barlasardic/nano-delay-pedal/manufacturing/DRILL-REPORT.txt

Drill report for delay-pedal.kicad_pcb
Created on 2026-10-10T01:16:54+0300

Copper Layer Stackup:
    =============================================================
    L1 :  F.Cu                      front
    L2 :  B.Cu                      back

Drill file 'delay-pedal-PTH.drl' contains
    plated through holes:
    =============================================================
    T1  0.300mm  0.0118"  (44 holes)
    T2  0.700mm  0.0276"  (44 holes)
    T3  0.750mm  0.0295"  (4 holes)
    T4  0.800mm  0.0315"  (61 holes)
    T5  1.000mm  0.0394"  (51 holes)
    T6  1.100mm  0.0433"  (5 holes)

    Total plated holes count 209

Drill file 'delay-pedal-NPTH.drl' contains
    unplated through holes:
    =============================================================
    T1  2.700mm  0.1063"  (4 holes)

    Total unplated holes count 4
