barlasardic/nano-delay-pedal/docs/mechanical-fit.pdf

# CUSTOM COMPACT PEDAL / FIT PLAN

Revision C - enclosure concept, dimensions in mm

73 x 129 x 59 overall reference; exact panel hardware must be selected.

129

CUSTOM HOUSING ASSUMPTIONS

Wall thickness: 2.5

PCB origin: X 13.30, Y 8.00

Nano USB face: X 70.50

PCB holes in enclosure coordinates:

H1 17.11, 11.81

H2 65.37, 11.81

H3 17.11, 93.09

H4 65.37, 93.09

Solid green: PCB and Nano
Gold outlines: proposed panel parts Dashed gold: jack body reservations Jack bodies overlap the PCB in plan; their height must clear the components. USB opening shown in blue.
Cutout size depends on Nano and plug.

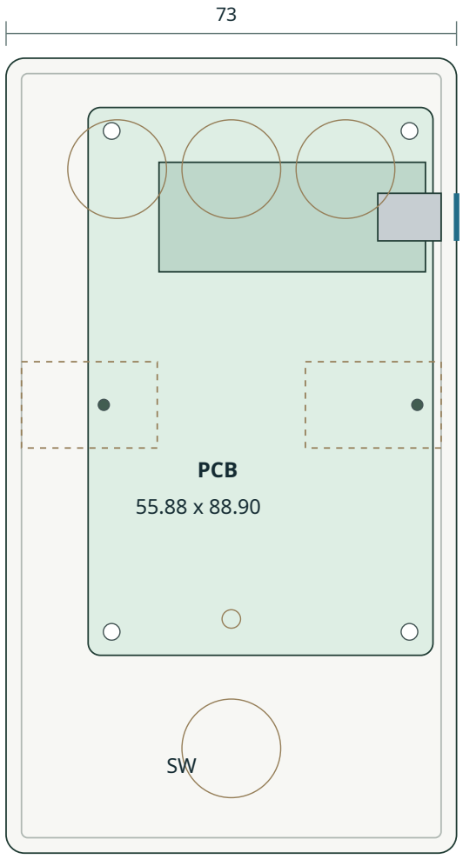
[picture p3: figure]
PCB 55.88 x 88.90

Fit checks before drilling the enclosure

Use the selected jack, pot, switch and Nano drawings to set panel holes.

Start with 5 mm clearance below the PCB and 25 mm above it; confirm actual heights.

The 59 mm figure is an overall pedal reference, including external hardware.

Provide room for knobs, panel thickness, plugs, wires and strain relief.

This concept does not guarantee fit in an existing BOSS enclosure.

Reference: BOSS DS-1 published external dimensions (see design-review.md).

ENCLOSURE CONCEPT - use the next page for the exact PCB mounting pattern.

# PCB MOUNTING TEMPLATE / 1:1

Revision C - component side - print at 100%, with scaling disabled

Check the 50 mm scale bar with a ruler before transferring holes.

55.88

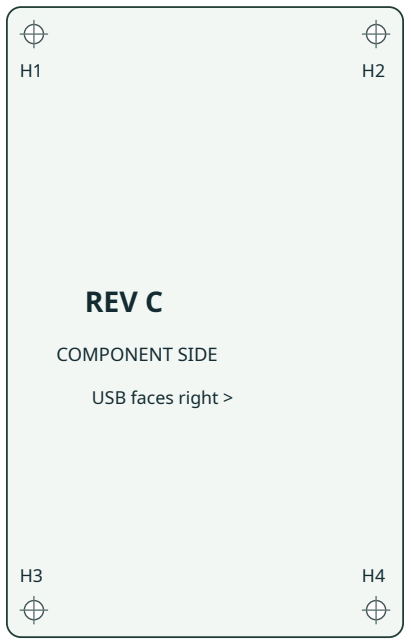
[picture p4: figure]
REV C; COMPONENT SIDE; USB faces right >

88.90

BOARD SPECIFICATION
55.88 x 88.90 x 1.60
Corner radius: 2.00
4 x diameter 2.70 NPTH
For M2.5 insulated standoffs Hole spacing: 48.26 x 81.28

HOLE CENTERS (PCB ORIGIN)
H1 3.81, 3.81
H2 52.07, 3.81
H3 3.81, 85.09
H4 52.07, 85.09

Origin: top-left board envelope X right; Y down.

50 mm calibration

Use this page only for PCB outline and mounting holes.

Do not use it to drill jack, pot, footswitch or USB openings.

Use insulated spacers; verify screw-head and wire clearances.

Keep the top/bottom orientation consistent when transferring the pattern.

Manufacturing board outline is the matching Edge.Cuts Gerber.

Dimensions are authoritative; reject any print whose calibration bar is not 50 mm.
