barlasardic/nano-delay-pedal/manufacturing/PROTOTYPE-NOTE.txt

Revision C, 2026-10-10. Unbuilt prototype; no firmware.
Read FABRICATION.txt and BOM.txt before manufacture.
CAD checks pass; circuit operation and enclosure fit require validation.
