barlasardic/nano-delay-pedal/manufacturing/assembly-top.pdf

# NANO DELAY / ASSEMBLY MAP

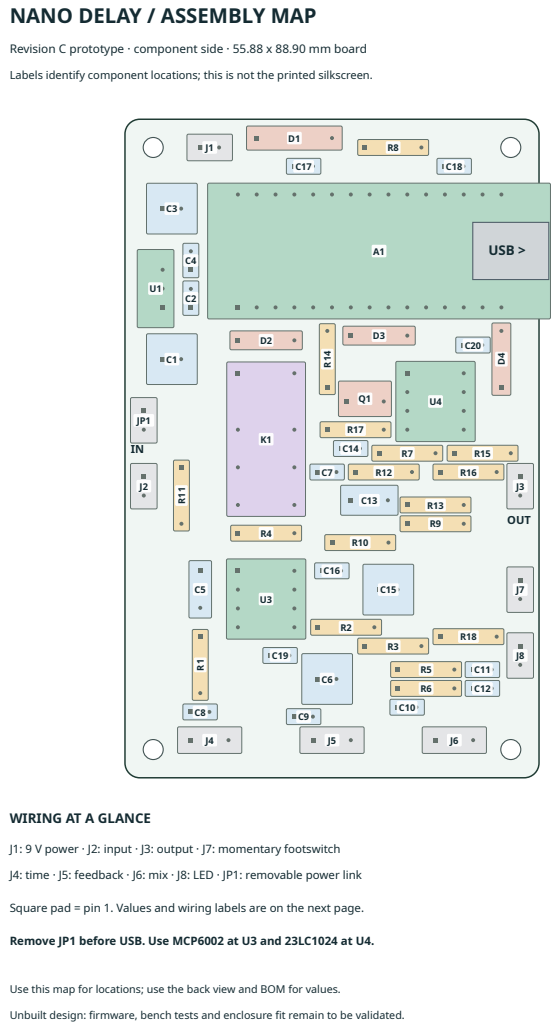
[picture p5: page 1]

Revision C prototype · component side · 55.88 x 88.90 mm board
Labels identify component locations; this is not the printed silkscreen. R¹⁴

J1: 9 V power · J2: input · J3: output · J7: momentary footswitch
J4: time · J5: feedback · J6: mix · J8: LED · JP1: removable power link

Square pad = pin 1. Values and wiring labels are on the next page.

Remove JP1 before USB. Use MCP6002 at U3 and 23LC1024 at U4.

Use this map for locations; use the back view and BOM for values.
Unbuilt design: firmware, bench tests and enclosure fit remain to be validated.

# NANO DELAY / VALUES & WIRING

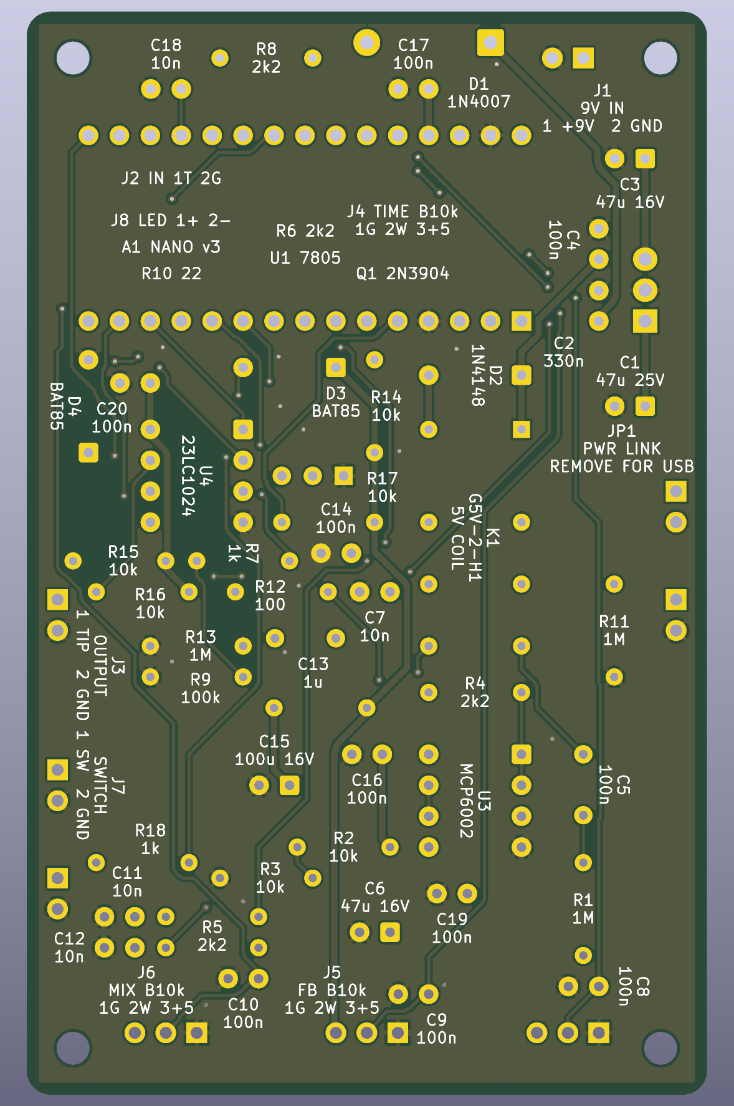
[picture p6: page 2]

Revision C - solder side, as seen from the underside

This view is mirrored relative to the component-side map.

2k2 = 2.2 kOhm; 100n = 100 nF. G = ground, W = wiper, T = tip.
