barlasardic/nano-delay-pedal/docs/assembly-top.pdf

# NANO DELAY / ASSEMBLY MAP

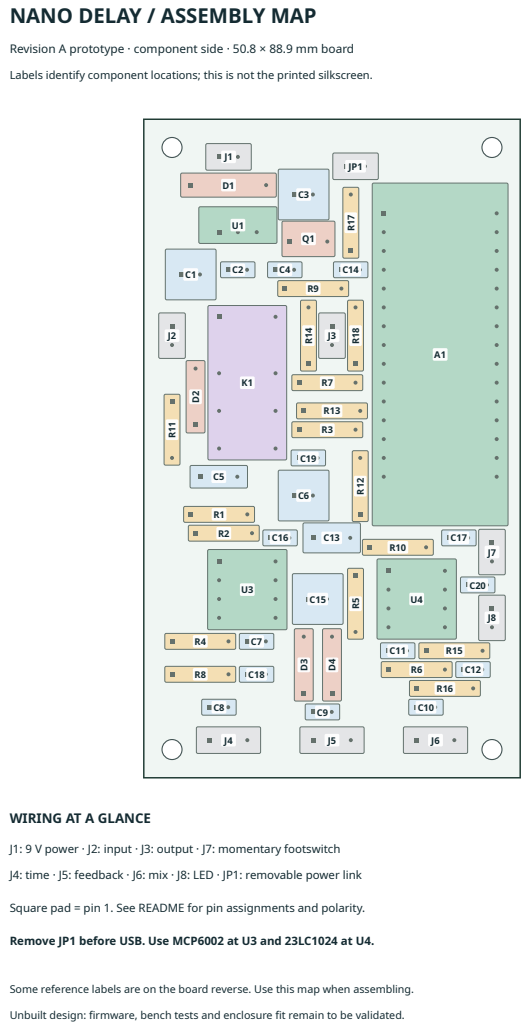
[picture p7: page 1]

Revision A prototype · component side · 50.8 × 88.9 mm board
Labels identify component locations; this is not the printed silkscreen.

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

Square pad = pin 1. See README for pin assignments and polarity.

Remove JP1 before USB. Use MCP6002 at U3 and 23LC1024 at U4.

Some reference labels are on the board reverse. Use this map when assembling.
Unbuilt design: firmware, bench tests and enclosure fit remain to be validated.
