barlasardic/nano-delay-pedal/delay-pedal.pdf

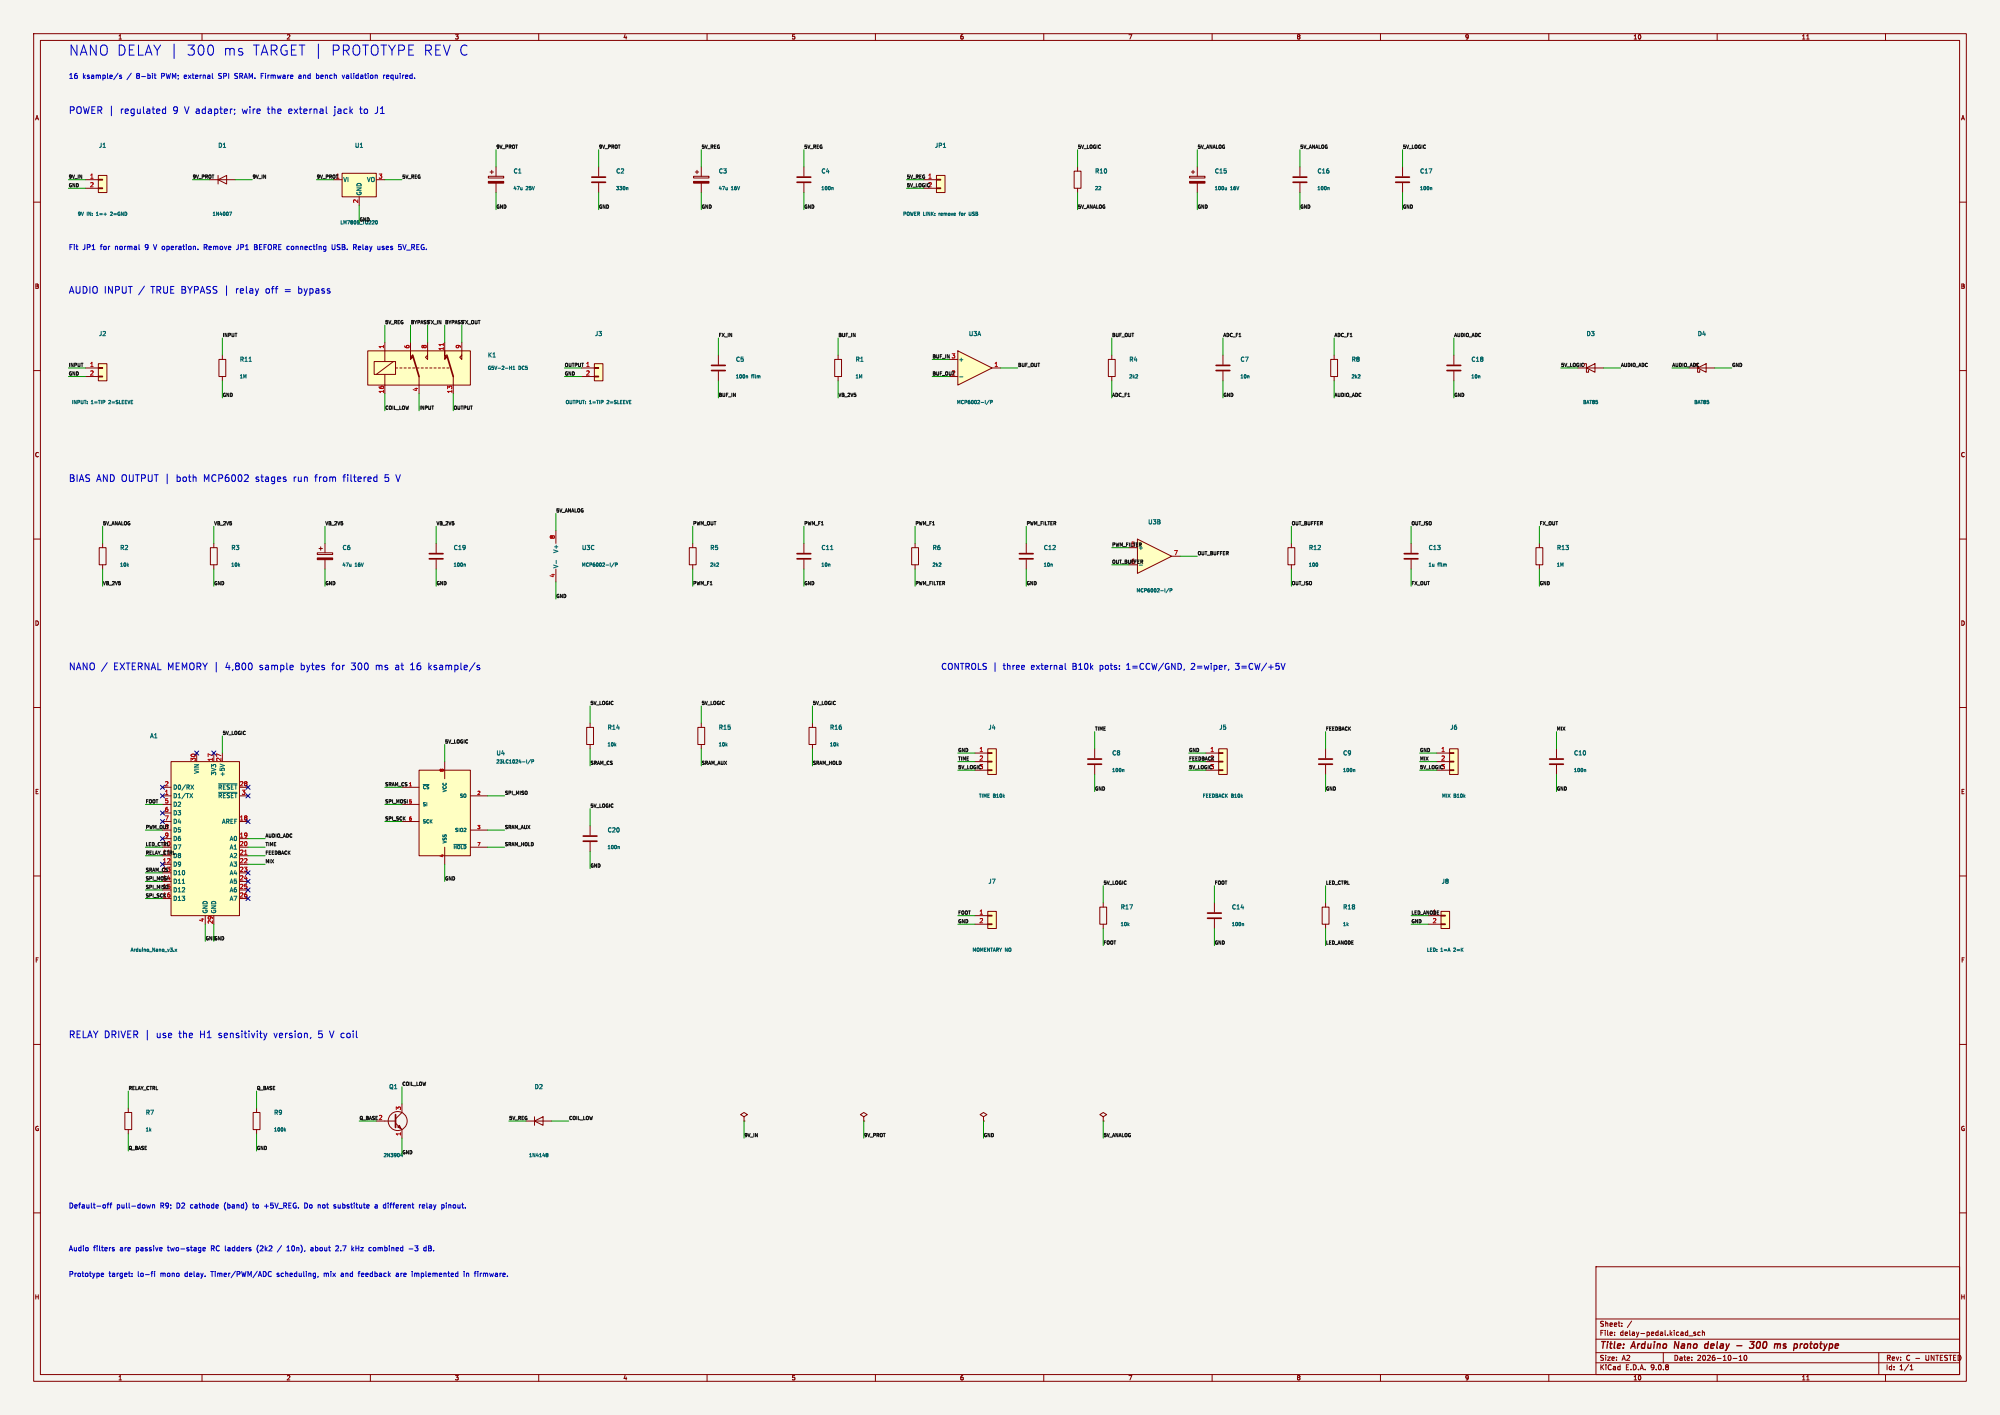
[picture p8: page 1]

NANO DELAY | 300 ms TARGET | PROTOTYPE REV C

POWER LINK: remove for USB V+

AUDIO INPUT / TRUE BYPASS | relay off = bypass

NANO / EXTERNAL MEMORY | 4,800 sample bytes for 300 ms at 16 ksample/s

File: delay-pedal.kicad_sch Sheet: /
