barlasardic/nano-delay-pedal/delay-pedal.kicad_pcb

## KiCad design delay-pedal.kicad_pcb (2026-10-09)

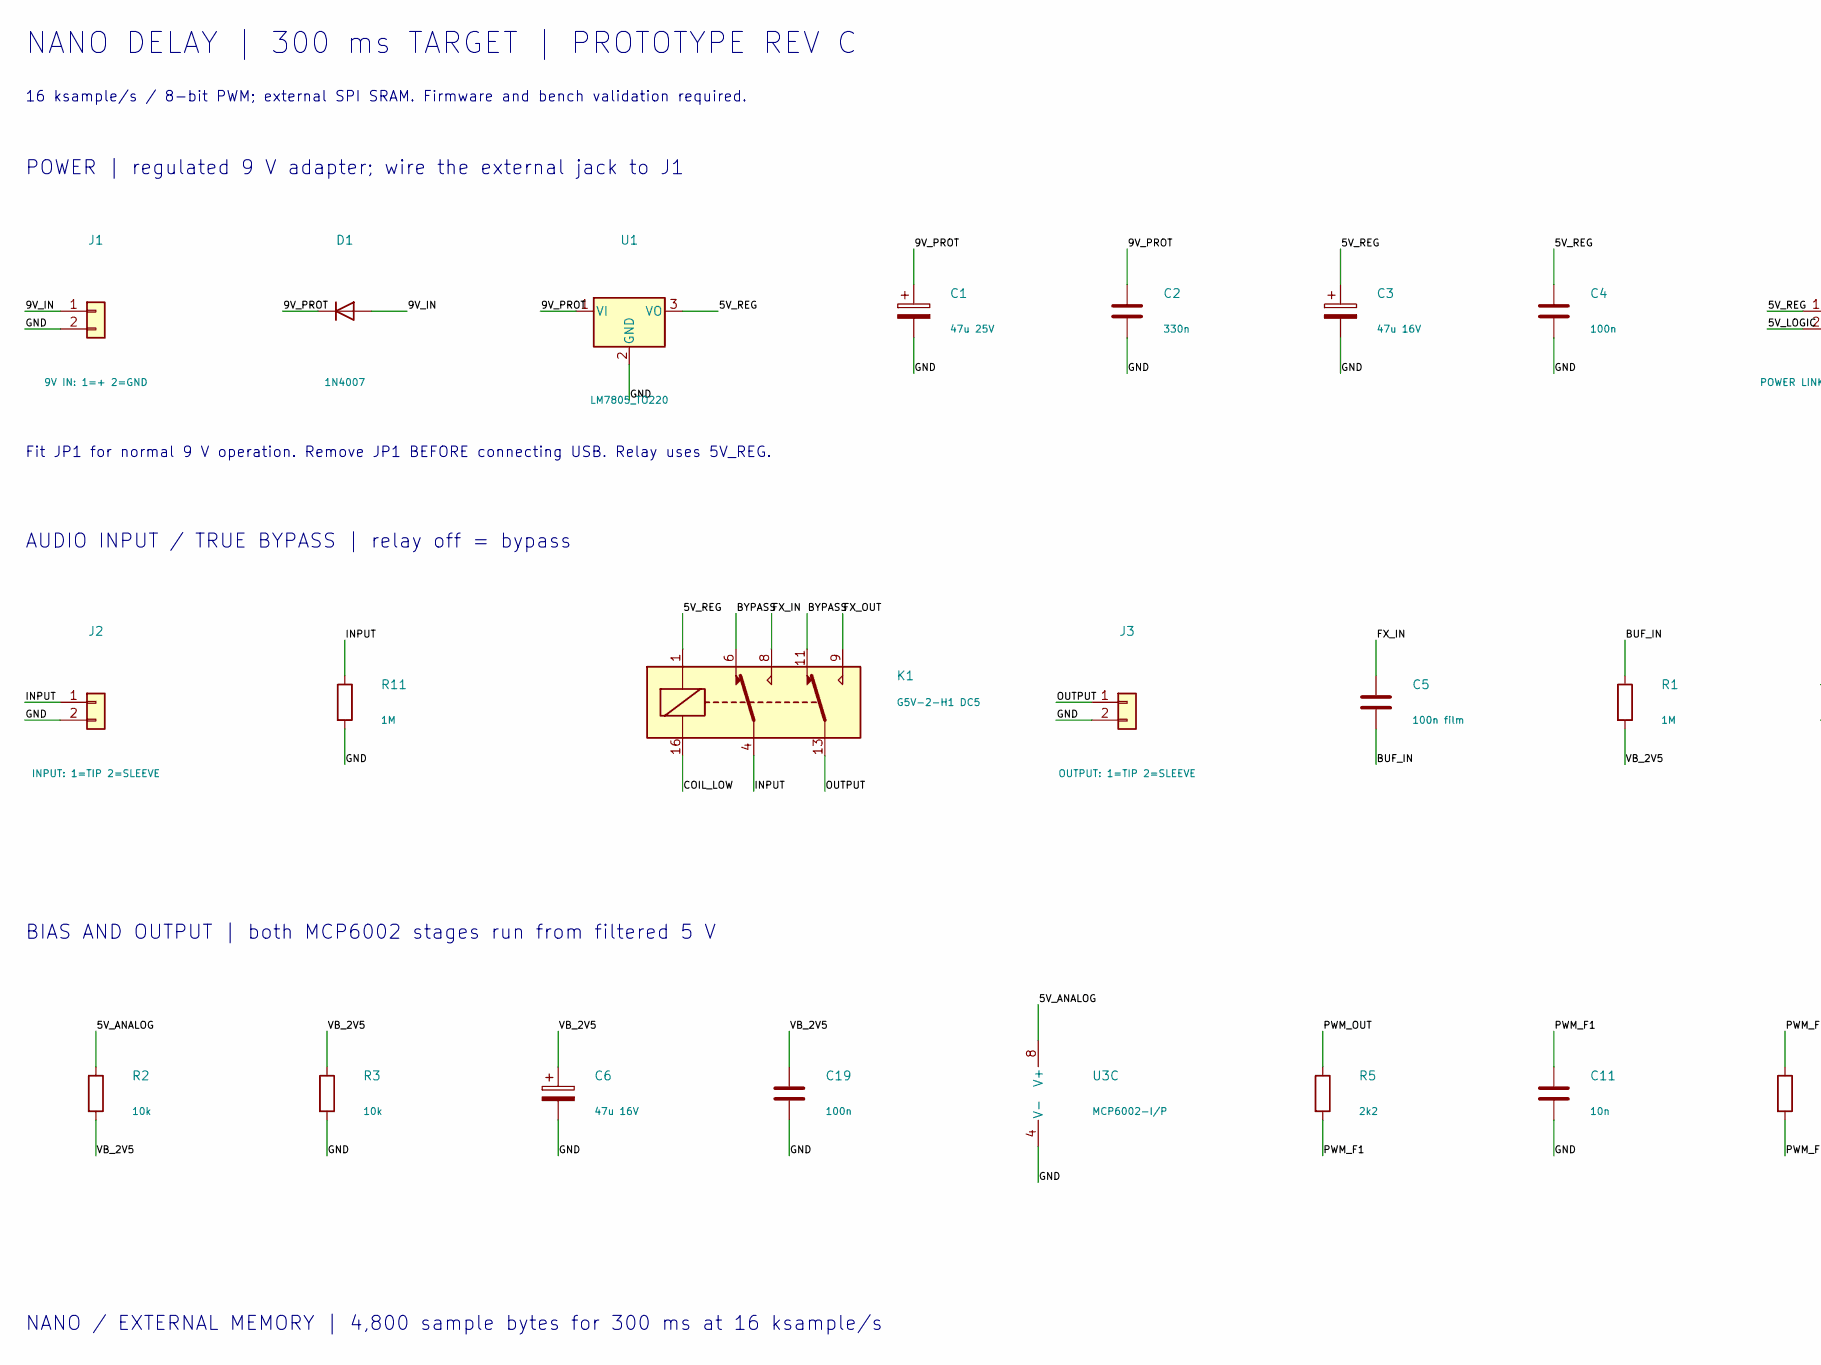
[picture p9: schematic delay-pedal.kicad_sch, Arduino Nano delay - 300 ms prototype, part in row 1, column 1]

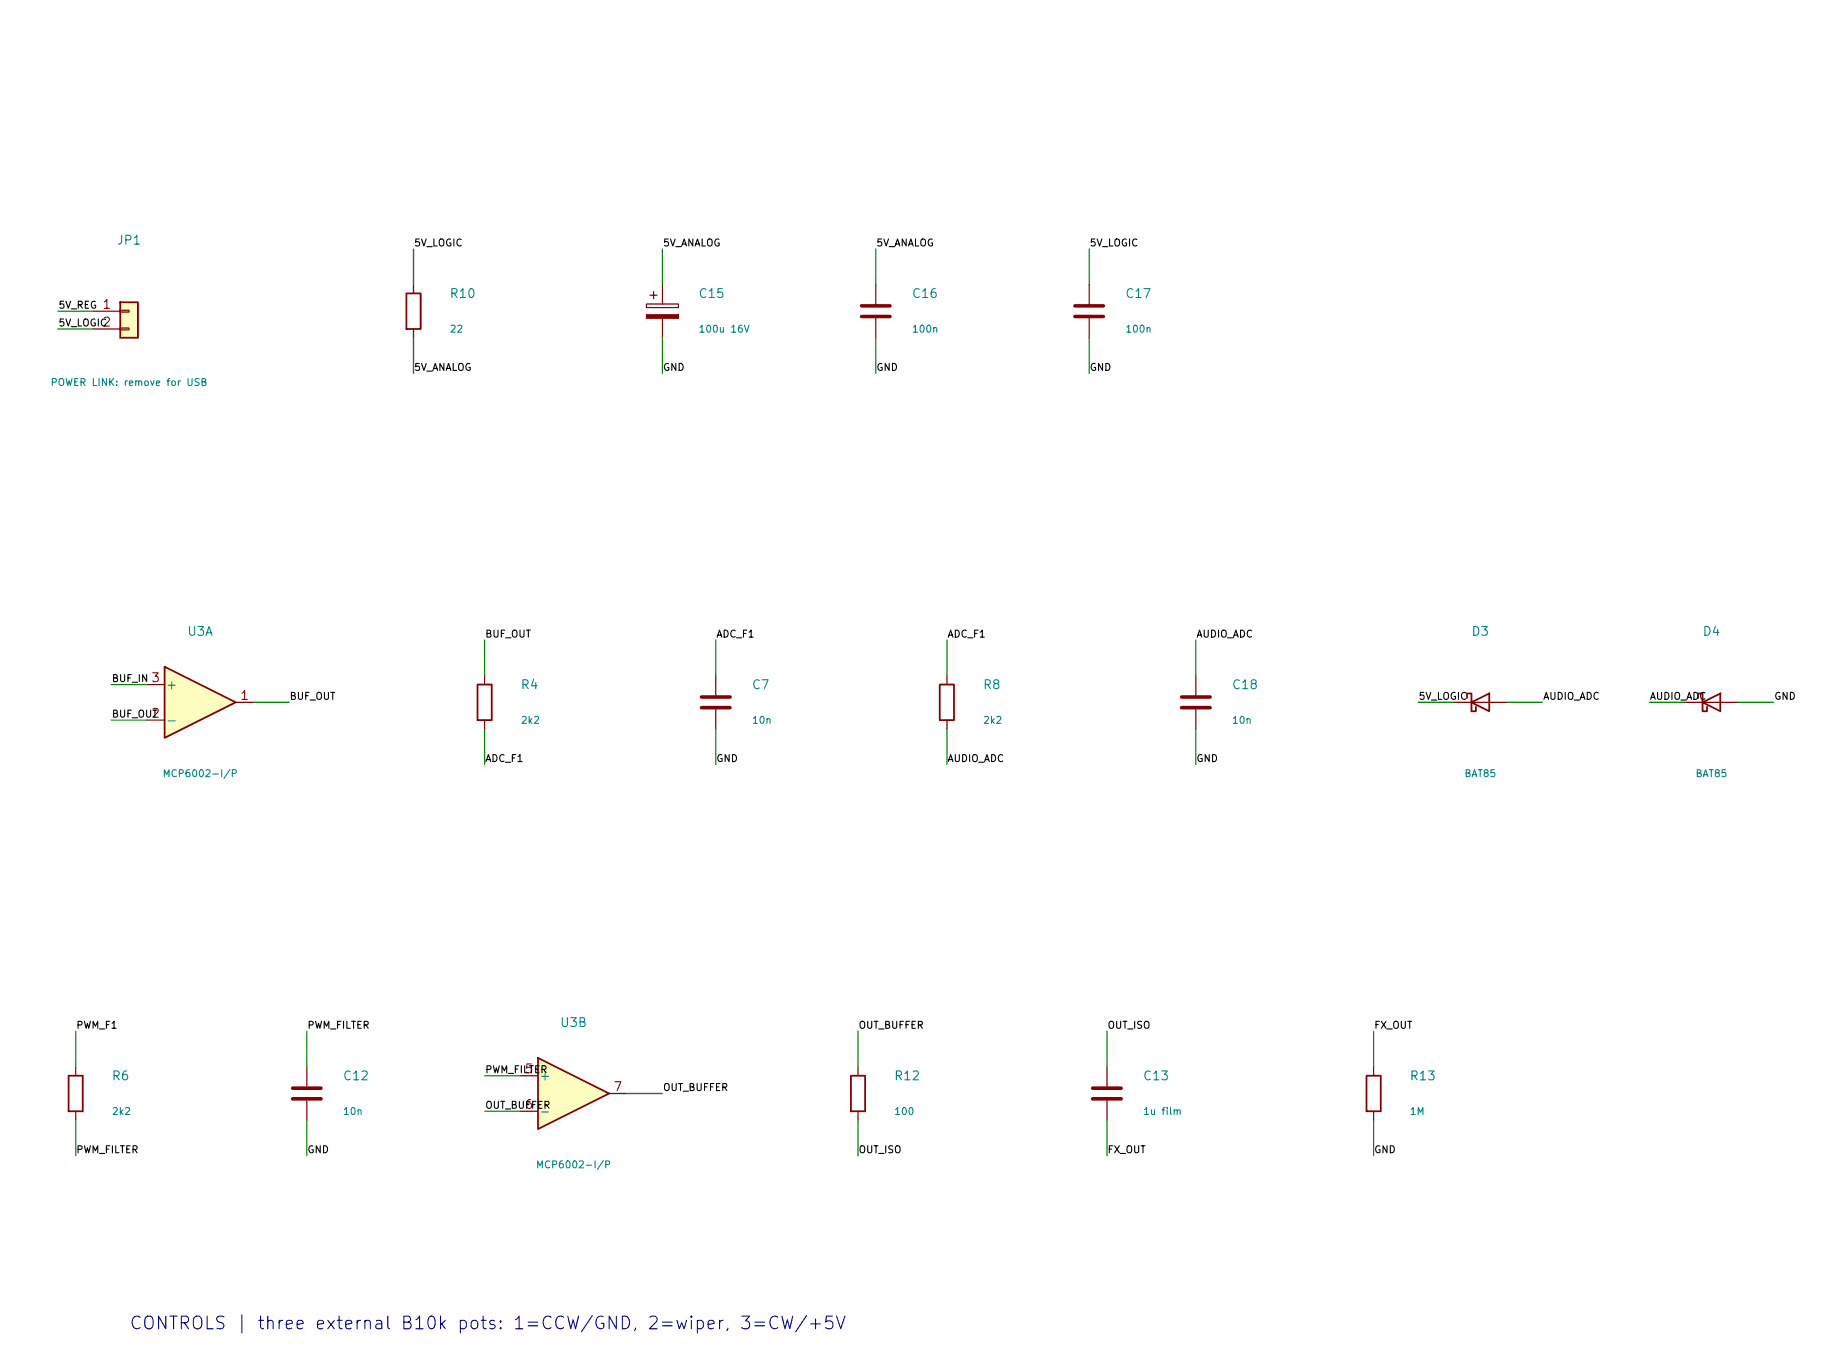
[picture p10: schematic delay-pedal.kicad_sch, Arduino Nano delay - 300 ms prototype, part in row 1, column 2]

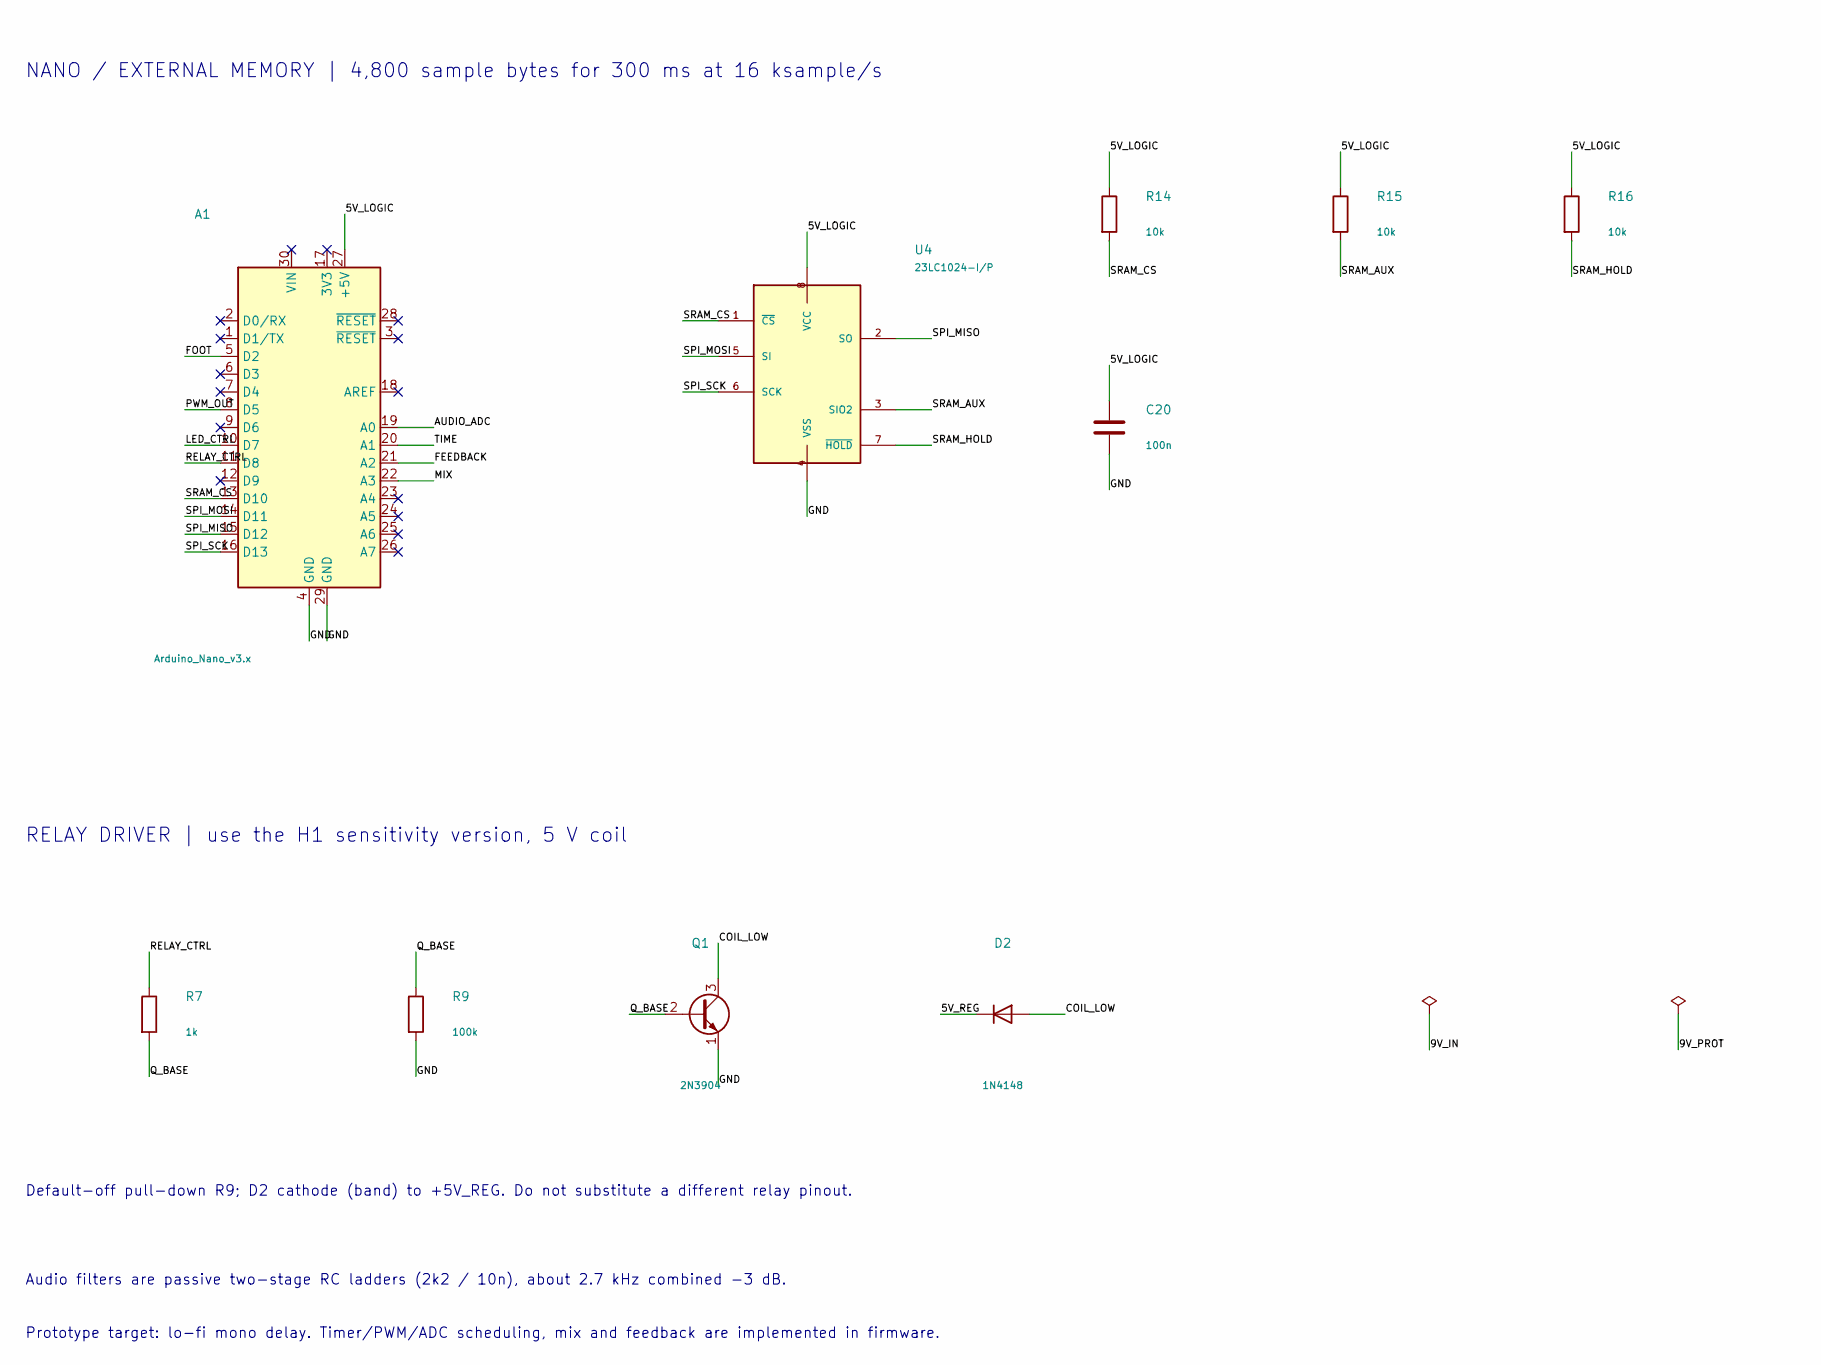
[picture p11: schematic delay-pedal.kicad_sch, Arduino Nano delay - 300 ms prototype, part in row 2, column 1]

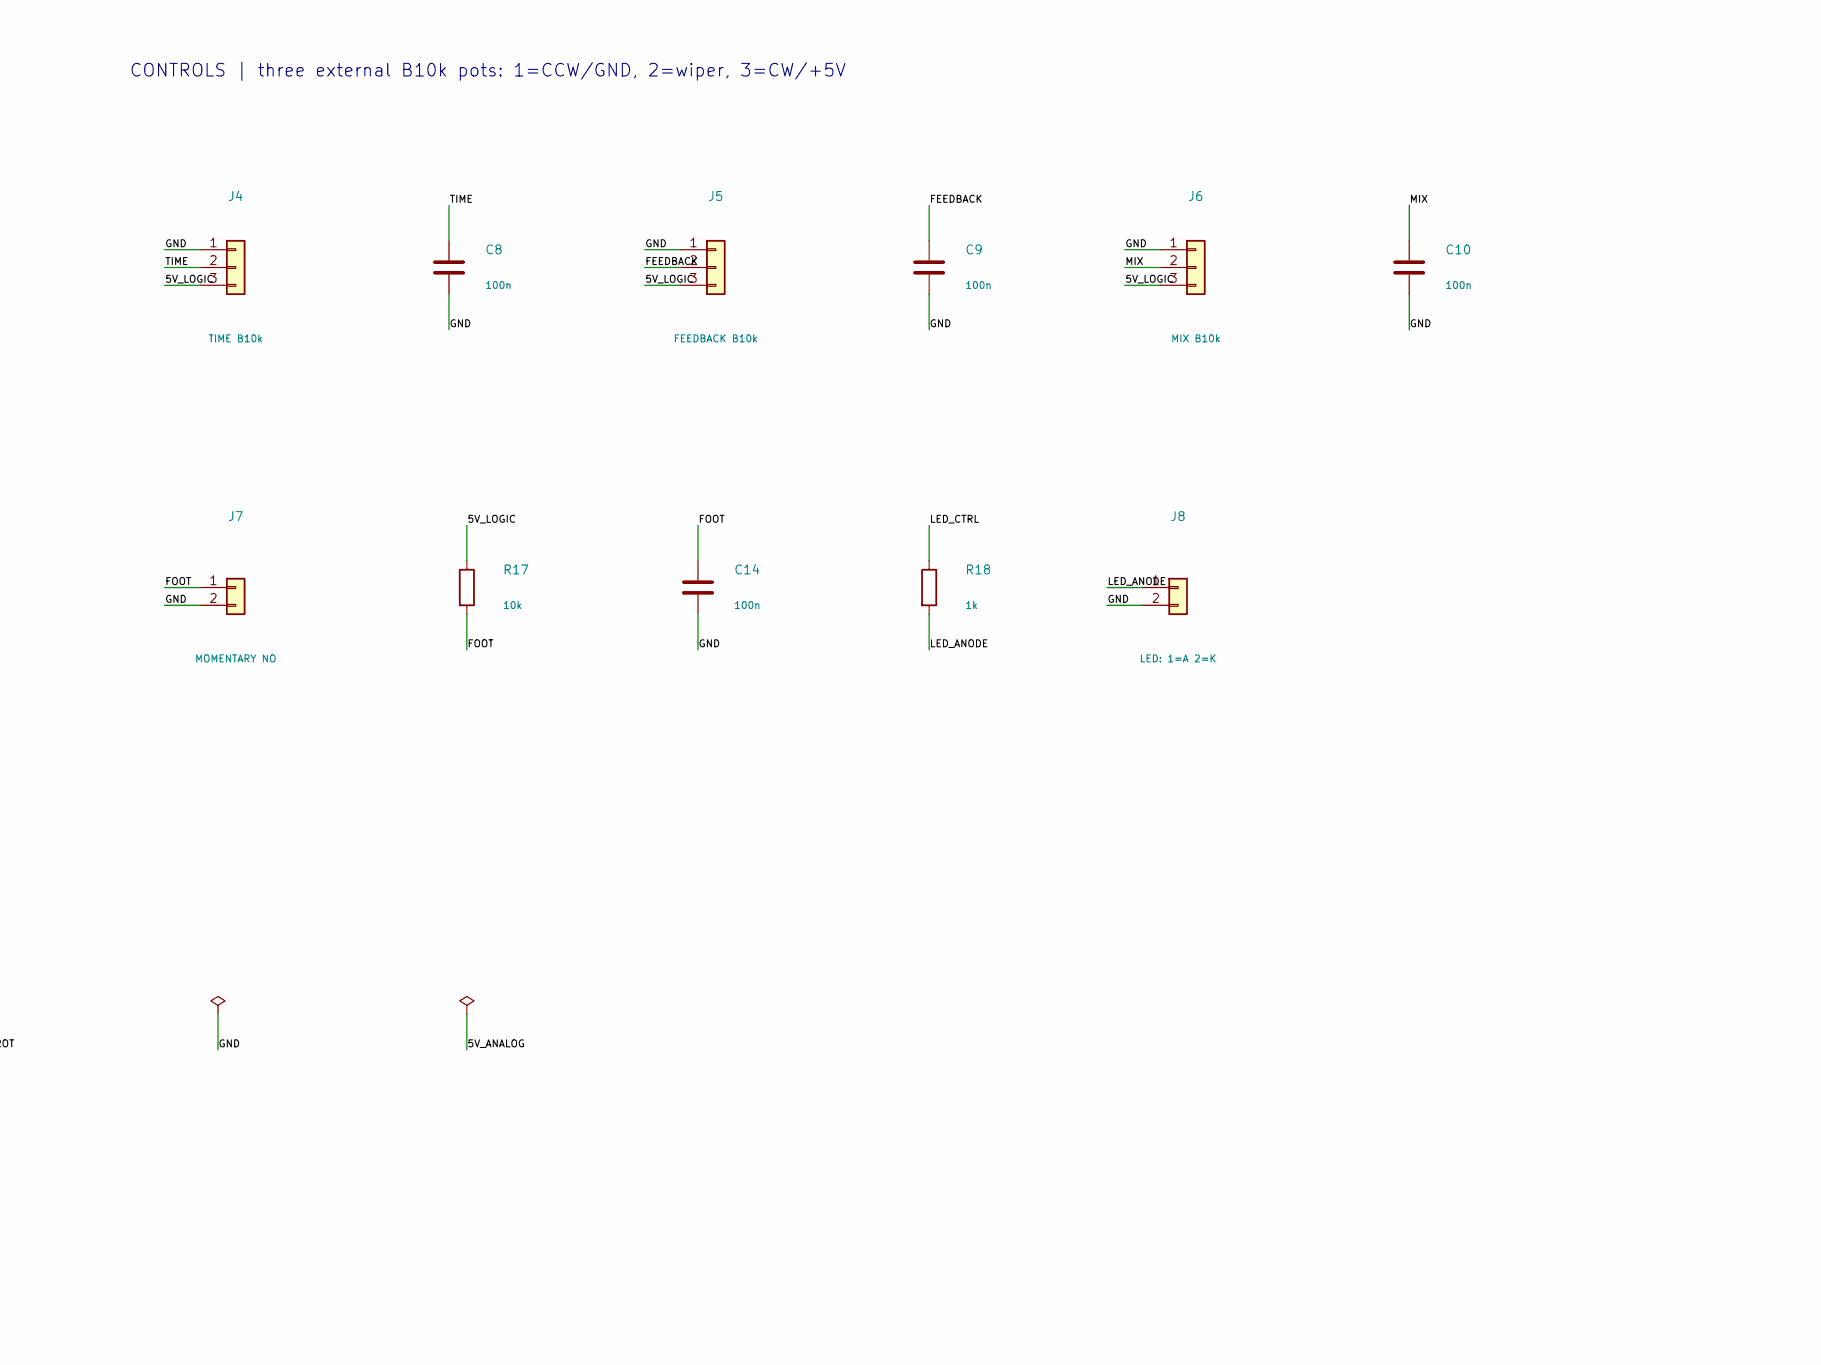
[picture p12: schematic delay-pedal.kicad_sch, Arduino Nano delay - 300 ms prototype, part in row 2, column 2]

Parts:
A1: Arduino_Nano_v3.x; Arduino_Nano_EdgeUSB
C1: 47u 25V; CP_Radial_D6.3mm_P2.50mm
C2: 330n; C_Disc_D3.0mm_W1.6mm_P2.50mm
C3, C6: 47u 16V; CP_Radial_D6.3mm_P2.50mm
C4, C8, C9, C10, C14, C16, C17, C19, C20: 100n; C_Disc_D3.0mm_W1.6mm_P2.50mm
C5: 100n film; C_Rect_L7.2mm_W2.5mm_P5.00mm
C7, C11, C12, C18: 10n; C_Disc_D3.0mm_W1.6mm_P2.50mm
C13: 1u film; C_Rect_L7.2mm_W3.5mm_P5.00mm
C15: 100u 16V; CP_Radial_D6.3mm_P2.50mm
D1: 1N4007; D_DO-41_SOD81_P10.16mm_Horizontal
D2: 1N4148; D_DO-35_SOD27_P7.62mm_Horizontal
D3, D4: BAT85; D_DO-35_SOD27_P7.62mm_Horizontal
J1: 9V IN: 1=+ 2=GND; PinHeader_1x02_P2.54mm_Vertical
J2: INPUT: 1=TIP 2=SLEEVE; PinHeader_1x02_P2.54mm_Vertical
J3: OUTPUT: 1=TIP 2=SLEEVE; PinHeader_1x02_P2.54mm_Vertical
J4: TIME B10k; PinHeader_1x03_P2.54mm_Vertical
J5: FEEDBACK B10k; PinHeader_1x03_P2.54mm_Vertical
J6: MIX B10k; PinHeader_1x03_P2.54mm_Vertical
J7: MOMENTARY NO; PinHeader_1x02_P2.54mm_Vertical
J8: LED: 1=A 2=K; PinHeader_1x02_P2.54mm_Vertical
JP1: POWER LINK: remove for USB; PinHeader_1x02_P2.54mm_Vertical
K1: G5V-2-H1 DC5; Relay_DPDT_Omron_G5V-2
Q1: 2N3904; TO-92_Inline_Wide
R1, R11, R13: 1M; R_Axial_DIN0204_L3.6mm_D1.6mm_P7.62mm_Horizontal
R2, R3, R14, R15, R16, R17: 10k; R_Axial_DIN0204_L3.6mm_D1.6mm_P7.62mm_Horizontal
R4, R5, R6, R8: 2k2; R_Axial_DIN0204_L3.6mm_D1.6mm_P7.62mm_Horizontal
R7, R18: 1k; R_Axial_DIN0204_L3.6mm_D1.6mm_P7.62mm_Horizontal
R9: 100k; R_Axial_DIN0204_L3.6mm_D1.6mm_P7.62mm_Horizontal
R10: 22; R_Axial_DIN0204_L3.6mm_D1.6mm_P7.62mm_Horizontal
R12: 100; R_Axial_DIN0204_L3.6mm_D1.6mm_P7.62mm_Horizontal
U1: LM7805_TO220; TO-220-3_Vertical
U3: MCP6002-I/P; DIP-8_W7.62mm_Socket
U4: 23LC1024-I/P; DIP-8_W7.62mm_Socket

Connections:
/5V_ANALOG: C15.1, C16.1, R2.1, R10.2, U3.8 (V+)
/5V_LOGIC: A1.27 (+5V), C17.1, C20.1, D3.1 (K), J4.3, J5.3, J6.3, JP1.2, R10.1, R14.1, R15.1, R16.1, R17.1, U4.8 (VCC)
/5V_REG: C3.1, C4.1, D2.1 (K), JP1.1, K1.1, U1.3 (VO)
/9V_IN: D1.2 (A), J1.1
/9V_PROT: C1.1, C2.1, D1.1 (K), U1.1 (VI)
/ADC_F1: C7.1, R4.2, R8.1
/AUDIO_ADC: A1.19 (A0), C18.1, D3.2 (A), D4.1 (K), R8.2
/BUF_IN: C5.2, R1.1, U3.3 (+)
/BUF_OUT: R4.1, U3.1, U3.2 (-)
/BYPASS: K1.6, K1.11
/COIL_LOW: D2.2 (A), K1.16, Q1.3 (C)
/FEEDBACK: A1.21 (A2), C9.1, J5.2
/FOOT: A1.5 (D2), C14.1, J7.1, R17.2
/FX_IN: C5.1, K1.8
/FX_OUT: C13.2, K1.9, R13.1
/GND: A1.4 (GND), A1.29 (GND), C1.2, C2.2, C3.2, C4.2, C6.2, C7.2, C8.2, C9.2, C10.2, C11.2, C12.2, C14.2, C15.2, C16.2, C17.2, C18.2, C19.2, C20.2, D4.2 (A), J1.2, J2.2, J3.2, J4.1, J5.1, J6.1, J7.2, J8.2, Q1.1 (E), R3.2, R9.2, R11.2, R13.2, U1.2 (GND), U3.4 (V-), U4.4 (VSS)
/INPUT: J2.1, K1.4, R11.1
/LED_ANODE: J8.1, R18.2
/LED_CTRL: A1.10 (D7), R18.1
/MIX: A1.22 (A3), C10.1, J6.2
/OUTPUT: J3.1, K1.13
/OUT_BUFFER: R12.1, U3.6 (-), U3.7
/OUT_ISO: C13.1, R12.2
/PWM_F1: C11.1, R5.2, R6.1
/PWM_FILTER: C12.1, R6.2, U3.5 (+)
/PWM_OUT: A1.8 (D5), R5.1
/Q_BASE: Q1.2 (B), R7.2, R9.1
/RELAY_CTRL: A1.11 (D8), R7.1
/SPI_MISO: A1.15 (D12), U4.2 (SO)
/SPI_MOSI: A1.14 (D11), U4.5 (SI)
/SPI_SCK: A1.16 (D13), U4.6 (SCK)
/SRAM_AUX: R15.2, U4.3 (SIO2)
/SRAM_CS: A1.13 (D10), R14.2, U4.1 (~CS)
/SRAM_HOLD: R16.2, U4.7 (~HOLD)
/TIME: A1.20 (A1), C8.1, J4.2
/VB_2V5: C6.1, C19.1, R1.2, R2.2, R3.1

Notes on the sheet:
NANO DELAY | 300 ms TARGET | PROTOTYPE REV C
16 ksample/s / 8-bit PWM; external SPI SRAM. Firmware and bench validation required.
POWER | regulated 9 V adapter; wire the external jack to J1
Fit JP1 for normal 9 V operation. Remove JP1 BEFORE connecting USB. Relay uses 5V_REG.
AUDIO INPUT / TRUE BYPASS | relay off = bypass
BIAS AND OUTPUT | both MCP6002 stages run from filtered 5 V
NANO / EXTERNAL MEMORY | 4,800 sample bytes for 300 ms at 16 ksample/s
CONTROLS | three external B10k pots: 1=CCW/GND, 2=wiper, 3=CW/+5V
RELAY DRIVER | use the H1 sensitivity version, 5 V coil
Default-off pull-down R9; D2 cathode (band) to +5V_REG. Do not substitute a different relay pinout.
Audio filters are passive two-stage RC ladders (2k2 / 10n), about 2.7 kHz combined -3 dB.
Prototype target: lo-fi mono delay. Timer/PWM/ADC scheduling, mix and feedback are implemented in firmware.

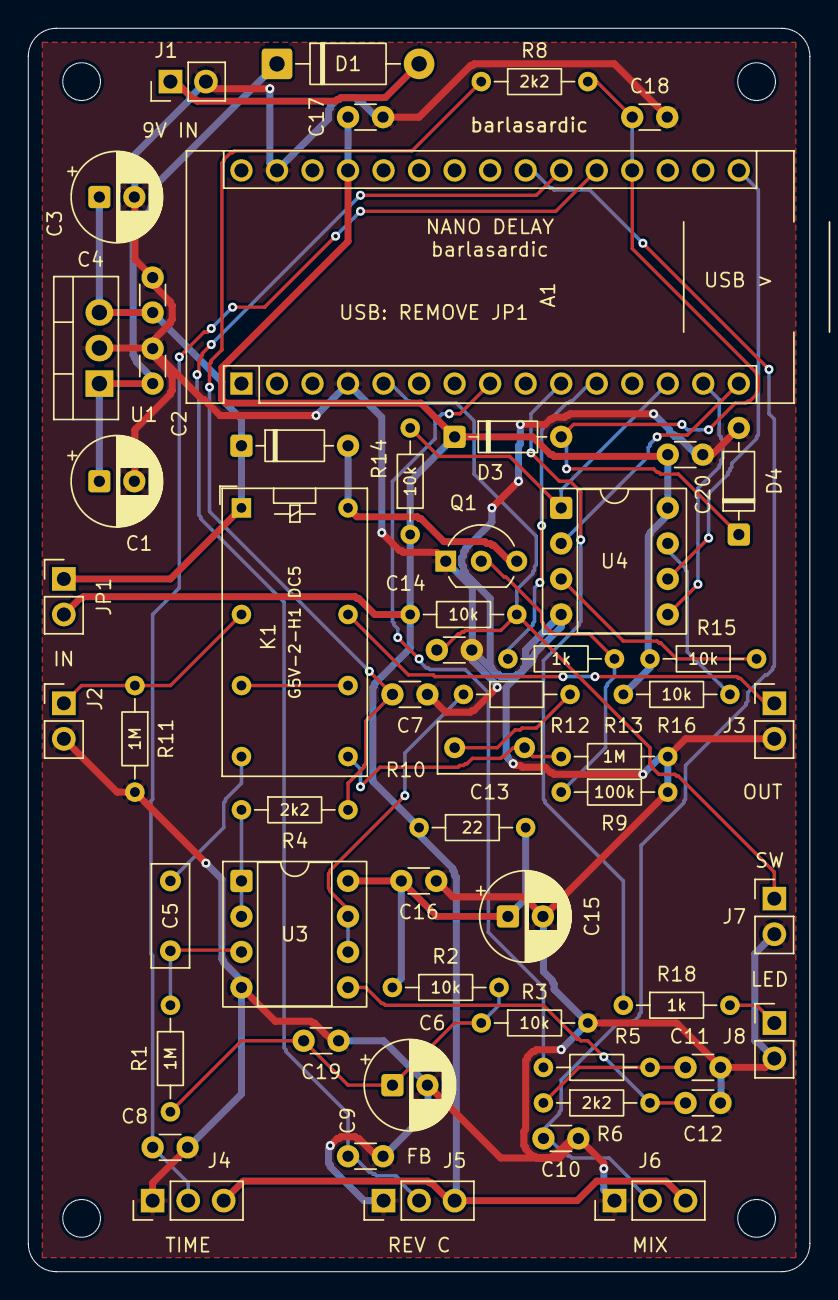
[picture p13: board delay-pedal.kicad_pcb from above]

Board: 2 copper layers, 55.9 x 88.9 mm, 61 parts (0 on the bottom side), 36 nets.

Other parts of the board:
H1, H2, H3, H4: M2.5; MountingHole_2.7mm_M2.5
