barlasardic/nano-delay-pedal/(commit log)

2026-10-08 Add routed 300 ms delay pedal prototype and hardware documentation
2026-10-09 Improve revision C PCB layout, labels and manufacturing documentation
